gnitish69/Smart-Chess-Learning-Board/SMART CHESS LEARNING BOARD/IMAGES/implementation.jpg

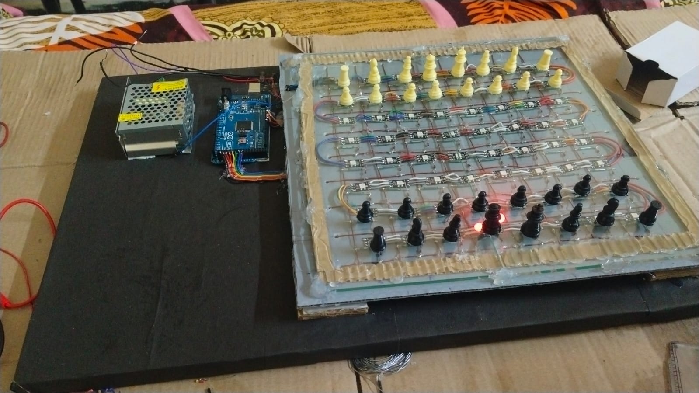
SMART CHESS LEARNING BOARD/IMAGES/implementation.jpg
