gnitish69/Smart-Chess-Learning-Board/SMART CHESS LEARNING BOARD/IMAGES/ref.jpg

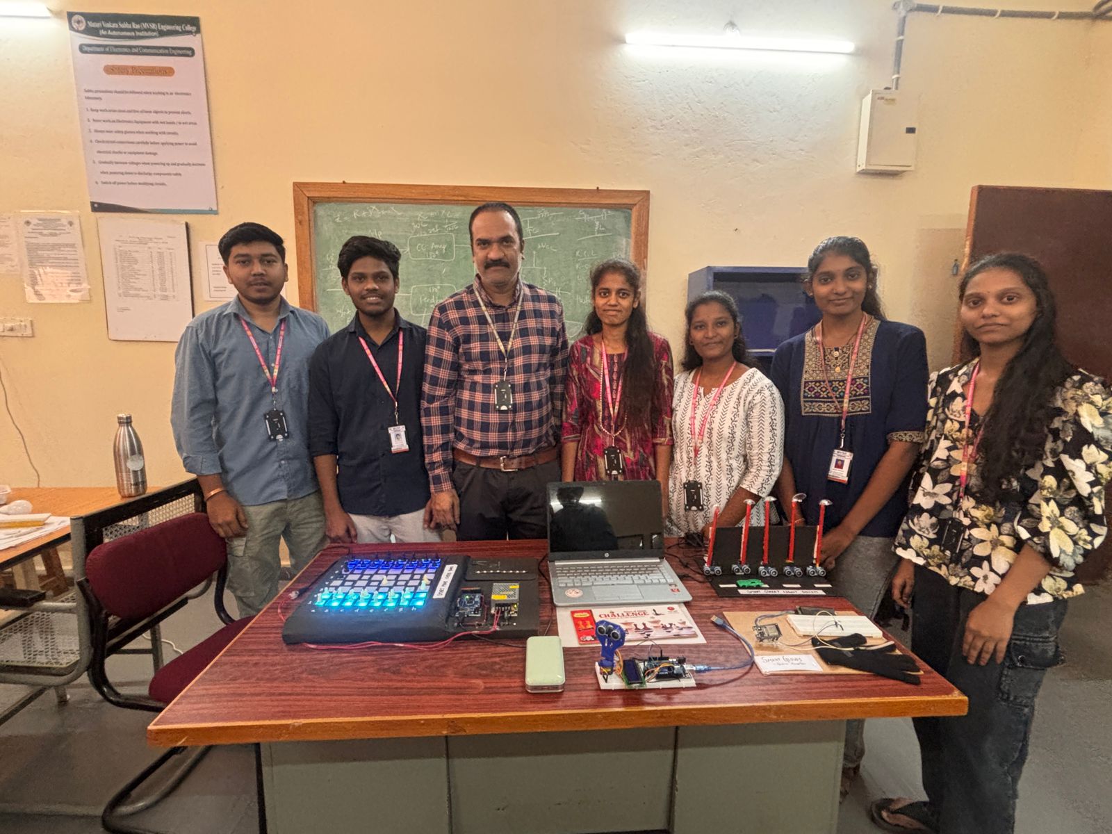
SMART CHESS LEARNING BOARD/IMAGES/ref.jpg
