gnitish69/Smart-Chess-Learning-Board/SMART CHESS LEARNING BOARD/IMAGES/finallook.jpg

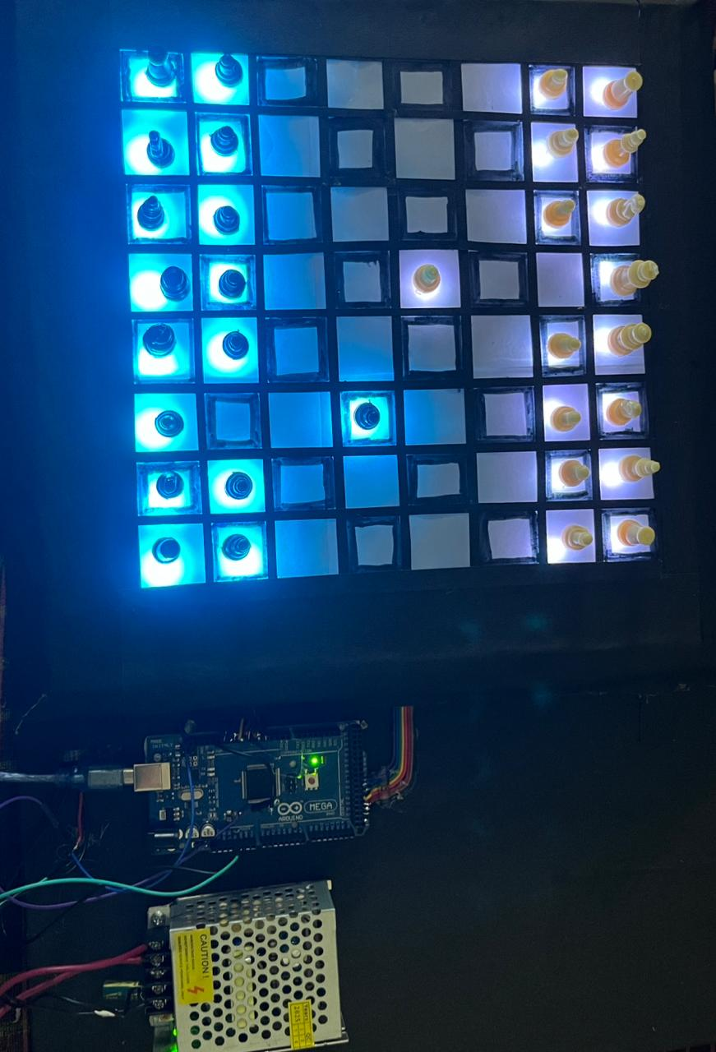
SMART CHESS LEARNING BOARD/IMAGES/finallook.jpg
