gnitish69/Smart-Chess-Learning-Board/SMART CHESS LEARNING BOARD/IMAGES/Mega.jpg

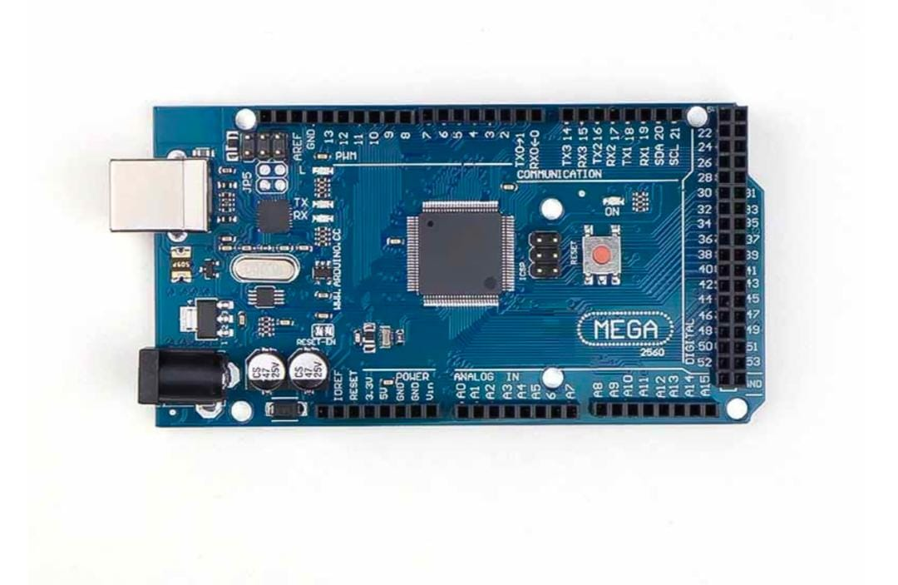
SMART CHESS LEARNING BOARD/IMAGES/Mega.jpg
