gnitish69/Smart-Chess-Learning-Board/SMART CHESS LEARNING BOARD/IMAGES/ref2.jpg

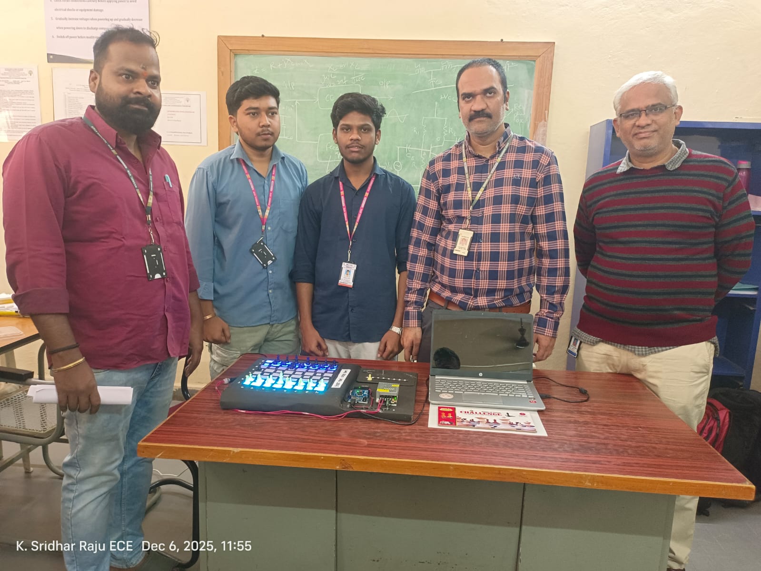
SMART CHESS LEARNING BOARD/IMAGES/ref2.jpg
