gnitish69/Smart-Chess-Learning-Board/SMART CHESS LEARNING BOARD/IMAGES/SMPS.jpg

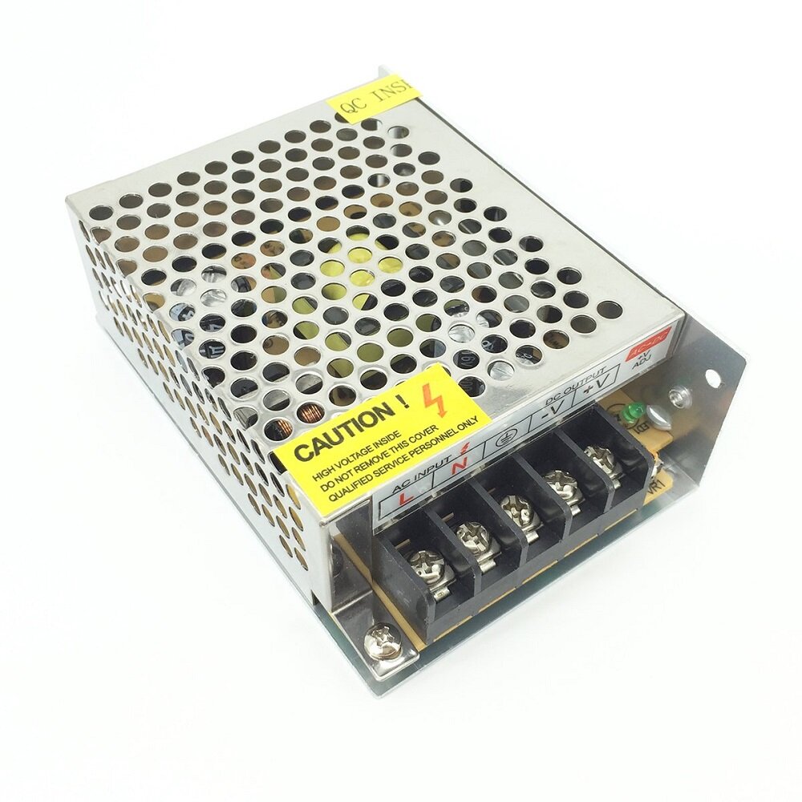
SMART CHESS LEARNING BOARD/IMAGES/SMPS.jpg
