gnitish69/Smart-Chess-Learning-Board/SMART CHESS LEARNING BOARD/IMAGES/WHATSAPP IMAGE 2026-02-14 AT 1.51.08 AM.jpeg

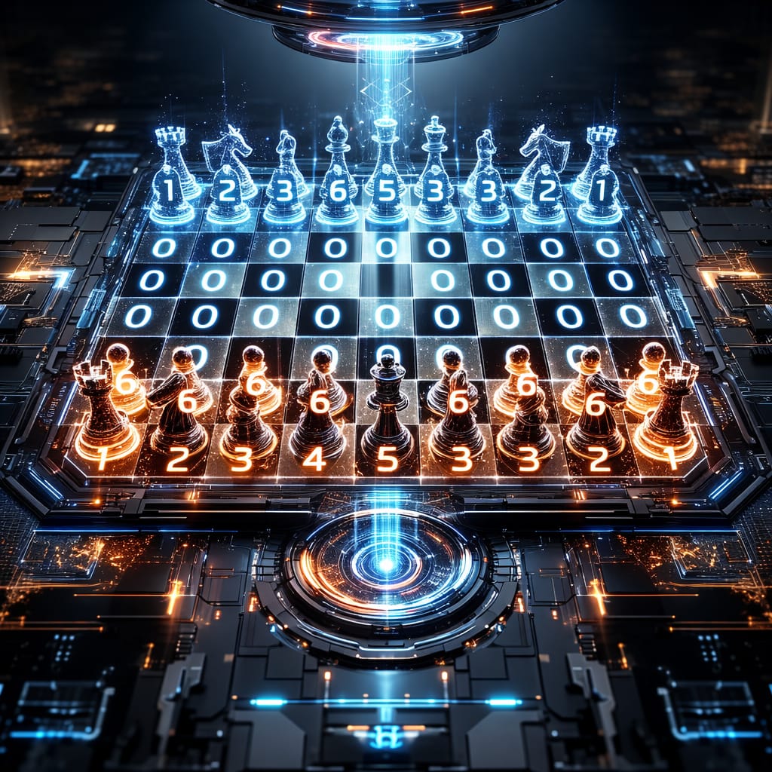
SMART CHESS LEARNING BOARD/IMAGES/WHATSAPP IMAGE 2026-02-14 AT 1.51.08 AM.jpeg
