gnitish69/Smart-Chess-Learning-Board/(list of files, drawings)

Other design files:
SMART CHESS LEARNING BOARD/PROTEUS/8x8_SwitchMatrix_iO.pdsprj
